nagars/WS2812B_ControlBoard/BOM WS28128.ods

Part Name | Part ID | No. | Link
DC Buck Converter Module |  | 1 | https://www.amazon.se/dp/B0B92ZDK6T?ref=ppx_yo2ov_dt_b_fed_asin_title
USBC QC/PD/AFC Module |  | 1 | https://www.amazon.se/dp/B0DGXHN5CT?ref=ppx_yo2ov_dt_b_fed_asin_title
Schottkey Diode | CUS520,H3F | 1 | https://www.digikey.se/en/products/detail/toshiba-semiconductor-and-storage/CUS520-H3F/5114303
ACScrew Terminal | TB002-500-02BE | 2 | https://www.digikey.se/en/products/detail/same-sky-formerly-cui-devices/TB002-500-02BE/10064069
3 Pin connector male | S3B-XH-A | 5 | https://www.digikey.se/en/products/detail/jst-sales-america-inc/S3B-XH-A/1651048
3 Pin housing | XHP-3 | 5 | https://www.digikey.se/en/products/detail/jst-sales-america-inc/XHP-3/1651017
Male to Male crimped wire | ASXHSXH22K152 | 8 | https://www.digikey.se/en/products/detail/jst-sales-america-inc/ASXHSXH22K152/6684931
Fuse | 0685T3500-01 | 1 | https://www.digikey.se/en/products/detail/bel-fuse-inc/0685T3500-01/4968269
MCU | 113991254 | 1 | https://www.digikey.se/en/products/detail/seeed-technology-co-ltd/113991254/24613066
0.1uF | CL05A104KP5NNNC | 1 | https://www.digikey.se/en/products/detail/samsung-electro-mechanics/CL05A104KP5NNNC/3886680
10uF | GRM155R60J106ME05D | 1 | https://www.digikey.se/en/products/detail/murata-electronics/GRM155R60J106ME05D/11500166
Buffer | MC74VHCT50ADTR2G | 1 | https://www.digikey.se/en/products/detail/onsemi/MC74VHCT50ADTR2G/921033
1000uF | RHS0J102MCN1GS | 1 | https://www.digikey.se/en/products/detail/nichicon/RHS0J102MCN1GS/2209464
470 ohm | RC0402FR-07470RL | 5 | https://www.digikey.se/en/products/detail/yageo/RC0402FR-07470RL/726619
