nagars/WS2812B_ControlBoard/WS2812B_Control_PCB/stepfiles/CAP_RHAHS_8X11P7_NCH.step

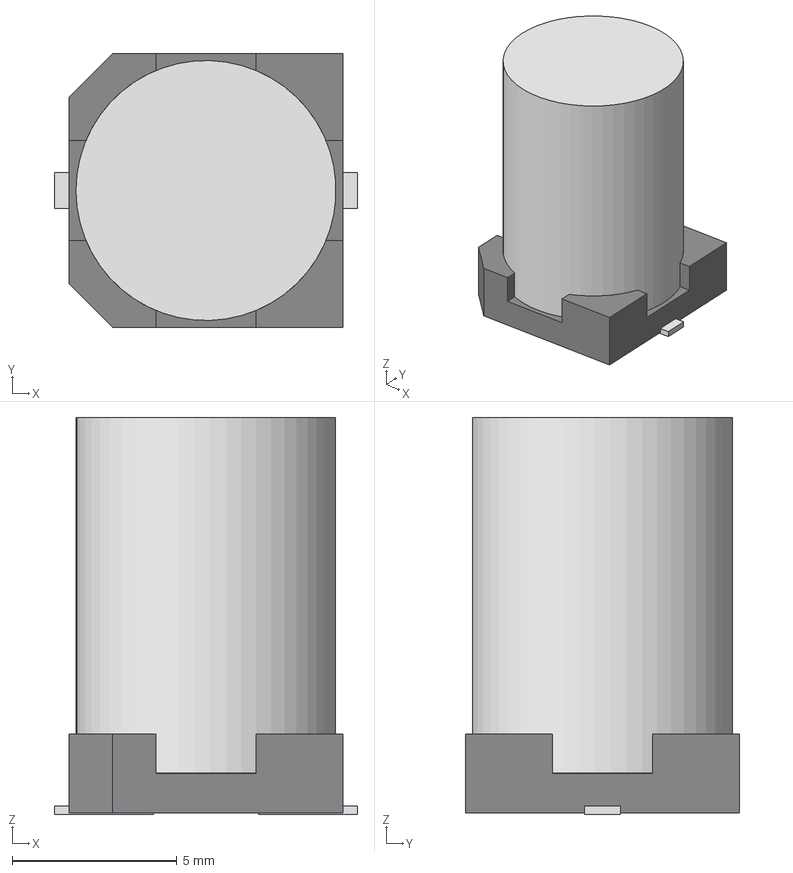
[picture p1: CAD file, 2026-08-28]
WS2812B_Control_PCB/stepfiles/CAP_RHAHS_8X11P7_NCH.step
9.19 x 8.31 x 12.0 mm
