nagars/WS2812B_ControlBoard/WS2812B_Control_PCB/stepfiles/IRM-20-5.step

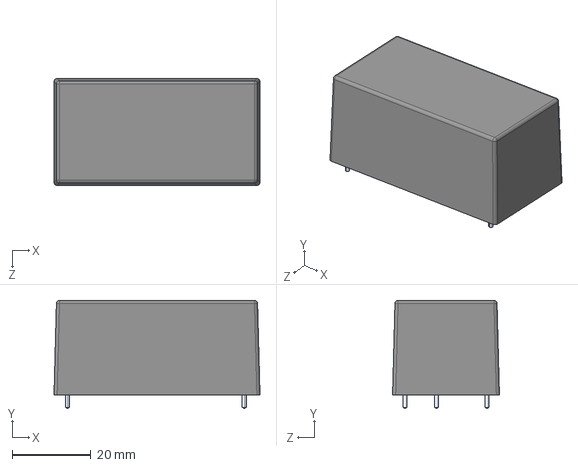
[picture p2: CAD file, 2026-08-28]
WS2812B_Control_PCB/stepfiles/IRM-20-5.step
52.4 x 27.5 x 27.2 mm
