nagars/WS2812B_ControlBoard/WS2812B_Control_PCB/stepfiles/RC0402FR-07470RL.step

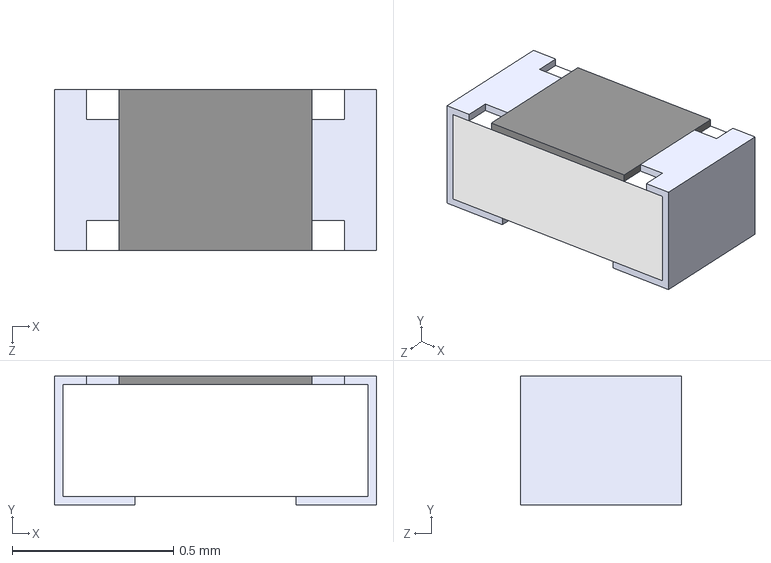
[picture p3: CAD file, 2026-08-28]
WS2812B_Control_PCB/stepfiles/RC0402FR-07470RL.step
1.00 x 0.4 x 0.5 mm
