nagars/WS2812B_ControlBoard/WS2812B_Control_PCB/stepfiles/USC-ZKN_r.stp

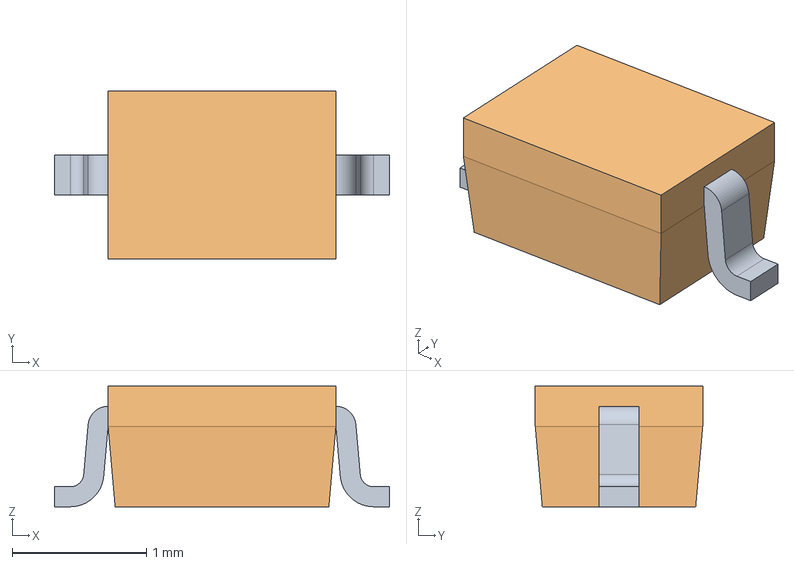
[picture p4: CAD file, 2026-08-28]
WS2812B_Control_PCB/stepfiles/USC-ZKN_r.stp
2.50 x 1.25 x 0.9 mm
