nagars/WS2812B_ControlBoard/WS2812B_Control_PCB/stepfiles/S3B-XH-A.step

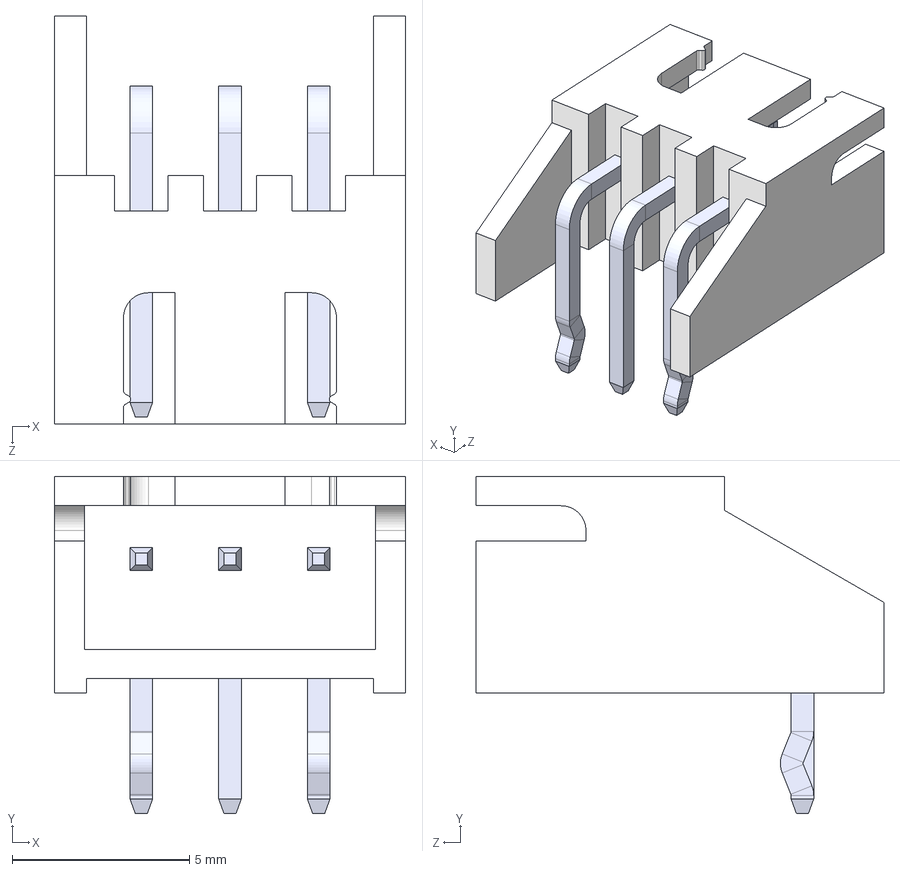
[picture p5: CAD file, 2026-08-28]
WS2812B_Control_PCB/stepfiles/S3B-XH-A.step
9.90 x 9.50 x 11.5 mm
SxB-XH-A_3
pin^SxB-XH-A ass_bent x 2
pin^SxB-XH-A ass
