nagars/WS2812B_ControlBoard/WS2812B_Control_PCB/stepfiles/TB002-500-02BE.step

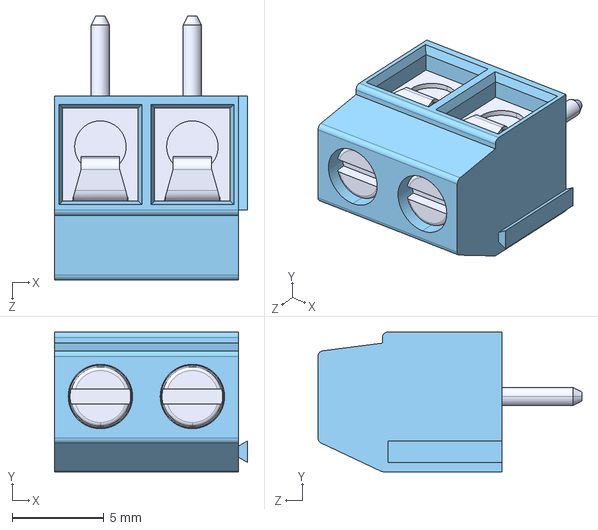
[picture p7: CAD file, 2026-08-28]
WS2812B_Control_PCB/stepfiles/TB002-500-02BE.step
10.5 x 7.60 x 14.4 mm
