nagars/WS2812B_ControlBoard/WS2812B_Control_PCB/stepfiles/MC74VHCT50ADTR2G.step

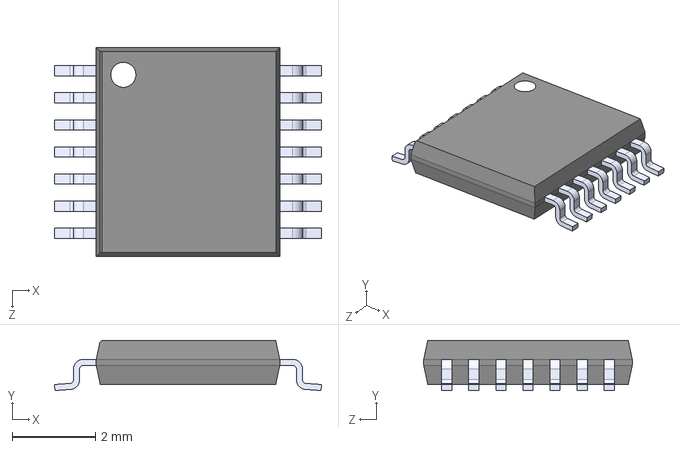
[picture p8: CAD file, 2026-08-28]
WS2812B_Control_PCB/stepfiles/MC74VHCT50ADTR2G.step
6.40 x 1.20 x 5.00 mm
