nagars/WS2812B_ControlBoard/WS2812B_Control_PCB/WS2812B_Control_PCB.kicad_pcb

## KiCad design WS2812B_Control_PCB/WS2812B_Control_PCB.kicad_pcb (2026-10-31)

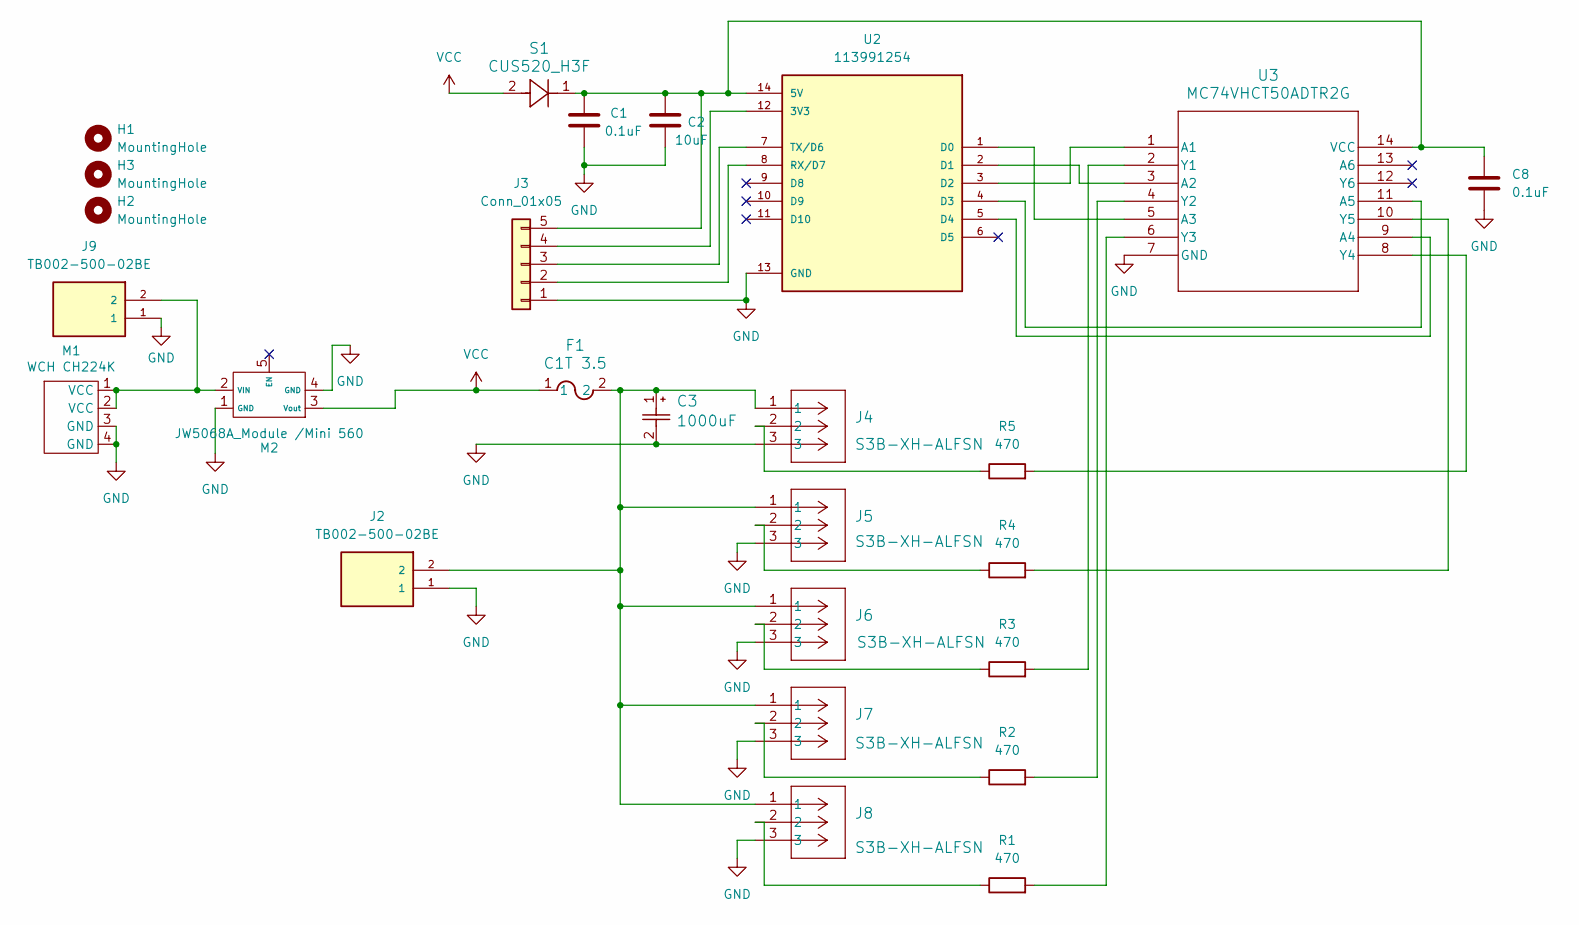
[picture p9: schematic WS2812B_Control_PCB.kicad_sch]

Parts:
C1, C8: 0.1uF; R_0402_1005Metric_Pad0.72x0.64mm_HandSolder
C2: 10uF; R_0402_1005Metric_Pad0.72x0.64mm_HandSolder
C3: 1000uF; CAP_RHA&slash_HS_8X11P7_NCH
F1: C1T 3.5; C1_BEL
H1, H2, H3: MountingHole; MountingHole_3.2mm_M3
J2, J9: TB002-500-02BE; CUI_TB002-500-02BE
J3: Conn_01x05; PinHeader_1x05_P2.54mm_Vertical
J4, J5, J6, J7, J8: S3B-XH-ALFSN; CONN_S3B-XH-ALFSN_JST
M1: WCH CH224K; WCH CH224K Module
M2: JW5068A_Module /Mini 560; JW5068A_Module
R1, R2, R3, R4, R5: 470; RESC1005X40N
S1: CUS520_H3F; USC_TOS
U2: 113991254; XIAO-ESP32-C6-DIP; PARTREV v1.0
U3: MC74VHCT50ADTR2G; TSSOP14_4P50X5P10_ONS

Connections:
GND: C1.2, C2.2, C3.2, C8.2, J2.1, J3.1, J4.3, J5.3, J6.3, J7.3, J8.3, J9.1, M1.3 (GND), M1.4 (GND), M2.1 (GND), M2.4 (GND), U2.13 (GND), U3.7 (GND)
unnamed: C3.1, F1.2, J2.2, J4.1, J5.1, J6.1, J7.1, J8.1
unnamed: J3.2, U2.8 (RX/D7)
unnamed: J3.3, U2.7 (TX/D6)
unnamed: J3.4, U2.12 (3V3)
unnamed: C1.1, C2.1, C8.1, J3.5, S1.1, U2.14 (5V), U3.14 (VCC)
unnamed: J4.2, R5.1
unnamed: J5.2, R4.1
unnamed: J6.2, R3.1
unnamed: J7.2, R2.1
unnamed: J8.2, R1.1
unnamed: J9.2, M1.1 (VCC), M1.2 (VCC), M2.2 (VIN)
unnamed: U2.1 (D0), U3.5 (A3)
unnamed: U2.2 (D1), U3.3 (A2)
unnamed: U2.3 (D2), U3.1 (A1)
unnamed: U2.4 (D3), U3.11 (A5)
unnamed: U2.5 (D4), U3.9 (A4)
unnamed: R3.2, U3.2 (Y1)
unnamed: R2.2, U3.4 (Y2)
unnamed: R1.2, U3.6 (Y3)
unnamed: R5.2, U3.8 (Y4)
unnamed: R4.2, U3.10 (Y5)
VCC: F1.1, M2.3 (Vout), S1.2

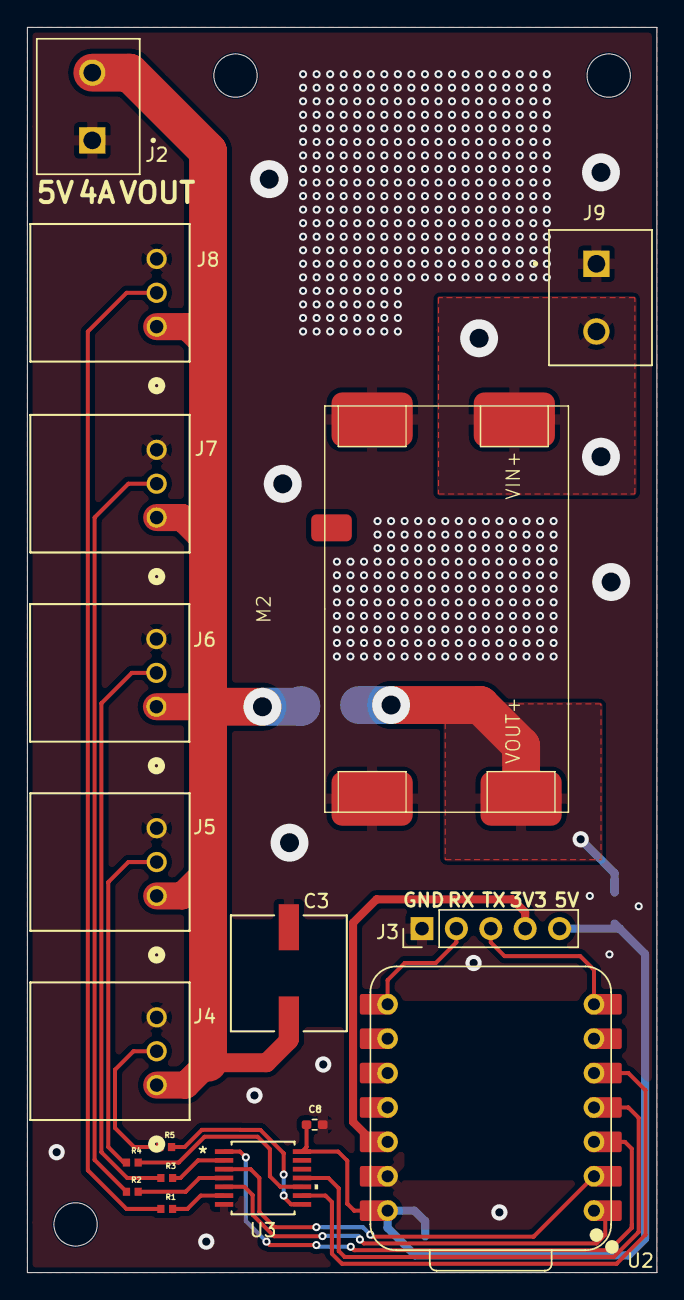
[picture p10: board WS2812B_Control_PCB.kicad_pcb from above]

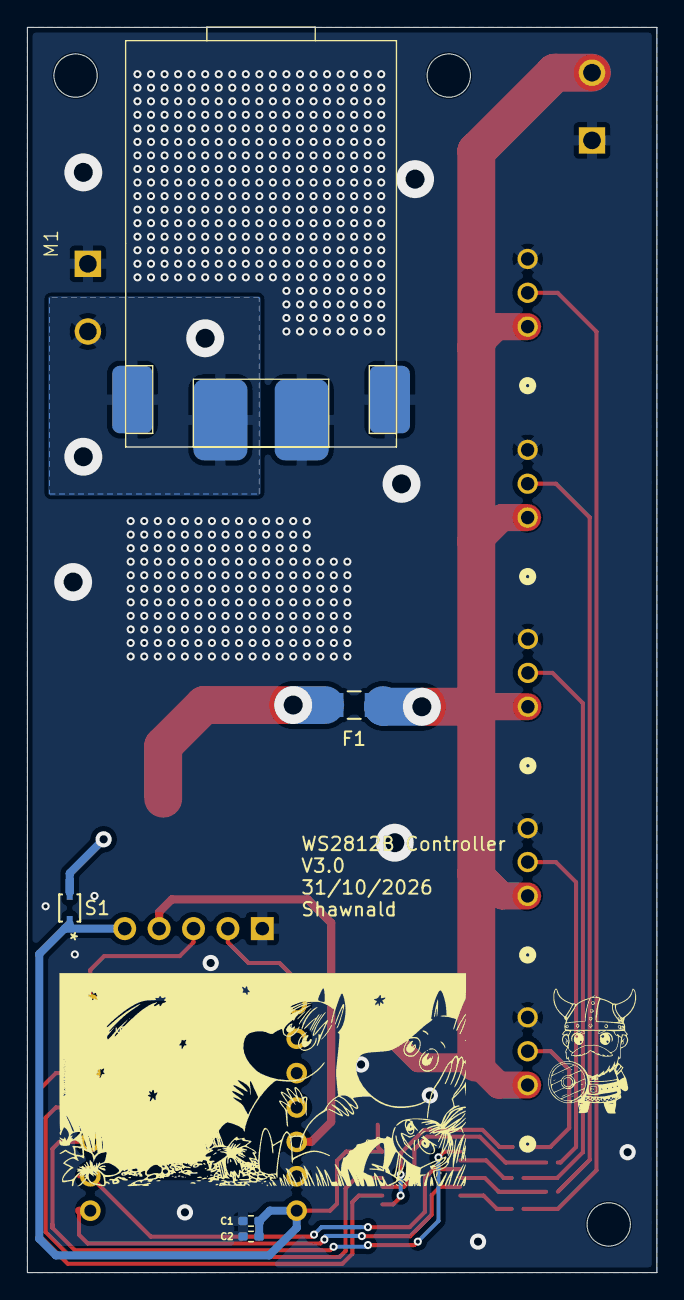
[picture p11: board WS2812B_Control_PCB.kicad_pcb from below]

Board: 2 copper layers, 46.5 x 91.9 mm, 26 parts (5 on the bottom side), 23 nets.
