nagars/WS2812B_ControlBoard/(commit log)

2026-08-28 Version 1 of control board
    [CAP_RHAHS_8X11P7_NCH.step, IRM-20-5.step, MC74VHCT50ADTR2G.step, RC0402FR-07470RL.step, S3B-XH-A.step, TB002-500-02BE.step, USC-ZKN_r.stp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]
2026-08-28 Add README for WS2812B Control Board
    Added detailed information about the WS2812B Control Board, including its features, power consumption calculations, hardware requirements, and safety warnings.
2026-08-28 Enhance README with schematic and PCB layout
    Added schematic and PCB layout images to README.
2026-08-28 Enhance README with power management details
    Added details about Schottkey diode and blowout protection.
2026-08-28 Added 4A current limit to silkscreen
    [WS2812B_Control_PCB.kicad_pcb]
2026-08-29 Added BOM
    [BOM WS28128.ods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]
2026-10-20 Fixed flaw in v1. Pinout of IRM-20-5 was incorrect. Corrected.
    [WS2812B_Control_PCB.kicad_pcb, WS2812B_Control_PCB.kicad_sch]
2026-10-22 Add new images to README for schematic and PCB layouts
2026-10-31 Changed version number on silkscreen
    [WS2812B_Control_PCB-B_Cu.gbr, WS2812B_Control_PCB-B_Mask.gbr, WS2812B_Control_PCB-B_Paste.gbr, WS2812B_Control_PCB-B_Silkscreen.gbr, WS2812B_Control_PCB-Edge_Cuts.gbr, WS2812B_Control_PCB-F_Cu.gbr, WS2812B_Control_PCB-F_Mask.gbr, WS2812B_Control_PCB-F_Paste.gbr]
2026-10-31 Replaced IRM-20-50 with a USB PD module + Buck Converter Module. Rationale: This system can be used with any 20W+ USB C Charger
    [BOM WS28128.ods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]
2026-10-31 Revise schematic and PCB layout sections with versions
    Updated schematic and PCB layout sections to include versions V1/V2 and V3.
